lilyinstarlight/derailleurs/README.md

The Derailleurs
===============

The Derailleurs aim to create a system for automatic rear gear switching on a standard bicycle. This repository contains everything we've made toward that goal.
