lilyinstarlight/derailleurs/hardware/greenboard/900-CH-7222-TH-TOP.tsv

DNP | J4 | 20.28 | 67.54 | 270
DNP | J3 | 2.5 | 67.54 | 90
DNP | J7 | 11.39 | 5.55 | 270
DNP | J5 | 2.5 | 34.53 | 90
DNP | J6 | 20.28 | 34.53 | 270
