lilyinstarlight/derailleurs/hardware/models/sensor_mount_top.stl

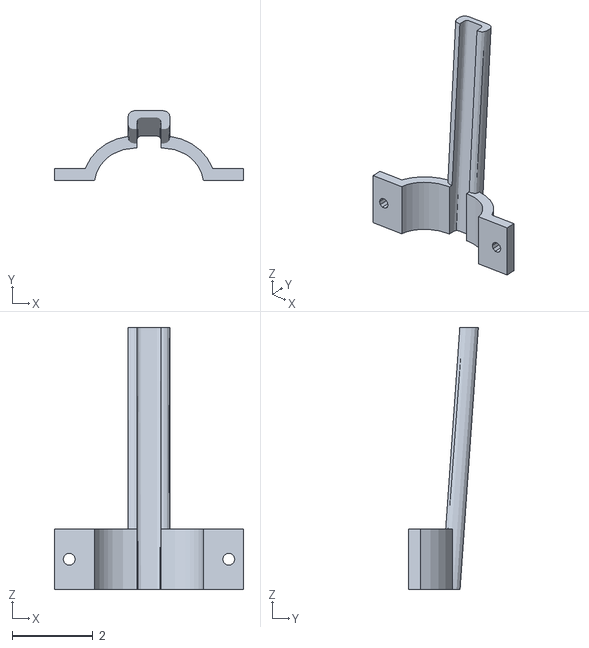
[picture p1: CAD file, 2016-11-09]
hardware/models/sensor_mount_top.stl
4.69 x 1.73 x 6.48
