lilyinstarlight/derailleurs/hardware/models/sensor_mount_bot.stl

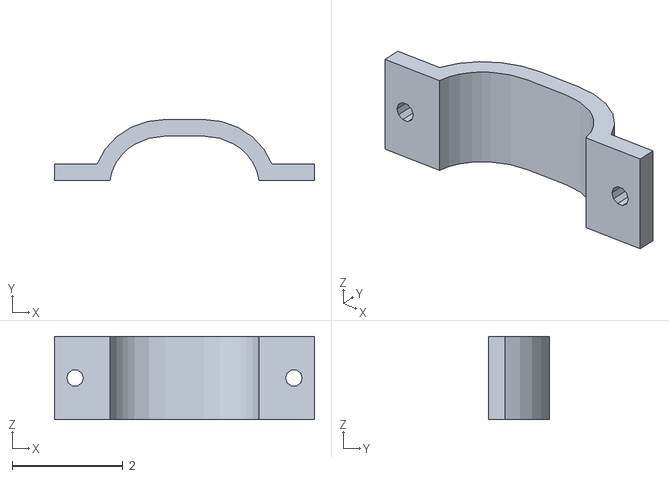
[picture p2: CAD file, 2016-11-09]
hardware/models/sensor_mount_bot.stl
4.69 x 1.10 x 1.50
