lilyinstarlight/derailleurs/hardware/models/turnbuckle_clamp_v1.stl

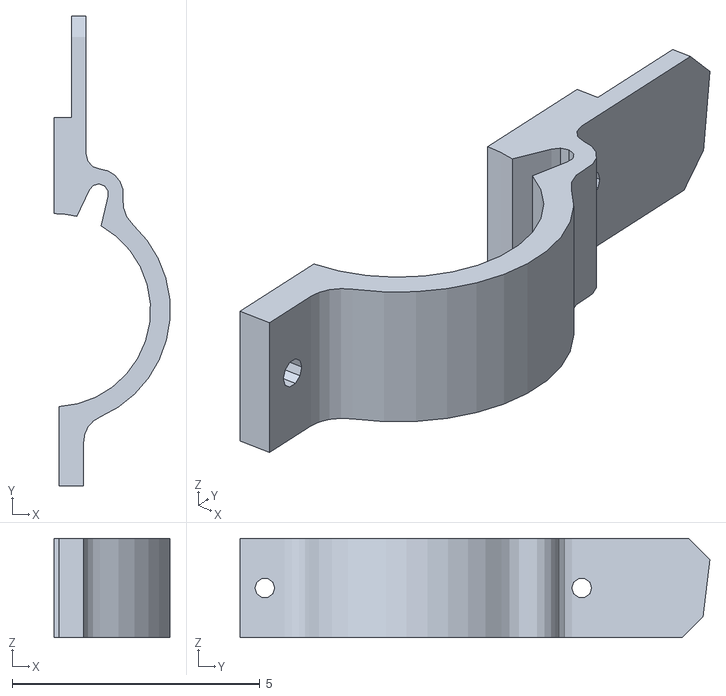
[picture p3: CAD file, 2016-11-07]
hardware/models/turnbuckle_clamp_v1.stl
2.34 x 9.49 x 2.00
