lilyinstarlight/derailleurs/hardware/models/motor_mount_v1_2.stl

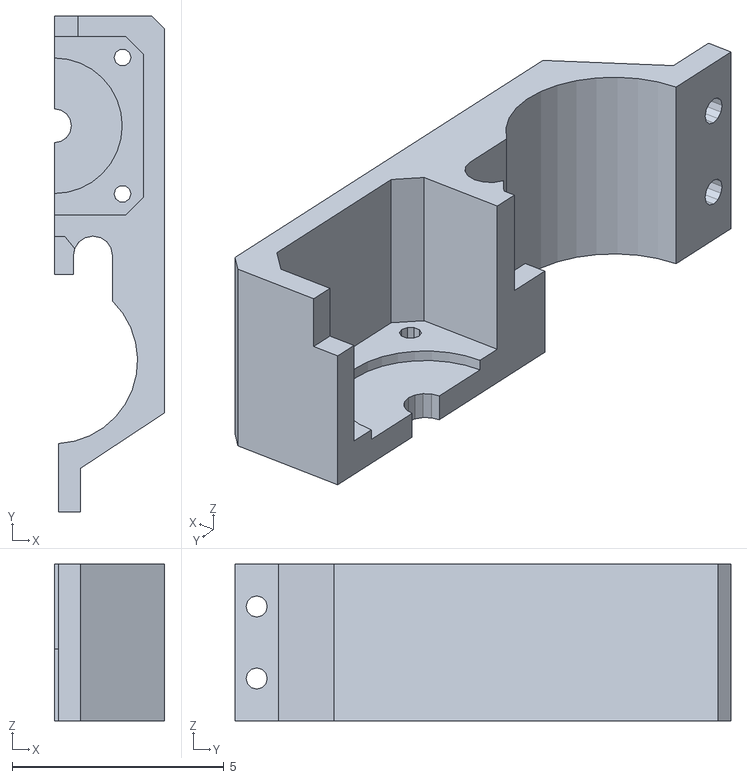
[picture p4: CAD file, 2016-11-04]
hardware/models/motor_mount_v1_2.stl
2.60 x 11.7 x 3.70
