lilyinstarlight/derailleurs/(list of files, cad)

Other CAD files:
hardware/models/motor_mount_v1.CATPart
hardware/models/turnbuckle_clamp_v1.CATPart
