lilyinstarlight/derailleurs/documents/testing.txt

=== TEAM INFO ===
Alice Stevens aksteve@clemson.edu
Foster McLane fmclane@clemson.edu
Mackenzie Binns mbinns@clemson.edu
Ryan Becwar rbecwar@g.clemson.edu

=== GITHUB INFO ===
github(current): https://github.com/fkmclane/derailleurs.git
buffet(mirror): buffet@buffet.cs.clemson.edu:mbinns/Derailleurs 

=== HALL EFFECT SENSOR TESTING ===
------------------------------------------------------------------------------
 hall_random_number:
------------------------------------------------------------------------------
    The hall random number test file tests a range of inputs that can be given from the hall effect sensor to ensure that it is calculating RPM correctly. The test is automatic and has a verify function that ensures the math is being done correctly based on the input given.

    We are calculating RPM based on the average number of magnets seen per second. This number is multiplied by 60 (to get a minute) then divided by 4 (number of magnets we have recording data) to get an RPM count for the rider

    This is important because it will control the motor telling it to shift either up or down

    To run this test open the diretory and run make upload, then to view the output run make monitor

------------------------------------------------------------------------------
 hall_decision_test:
------------------------------------------------------------------------------
    The decision test file is leveraging the random number generator from the last test to give the shift up and down commands. These commands are given if the cadence falls under a threshold (currently defined as 10 for proof of concept)

    This is important because without this logic the motor will never know when to shift the gear. This function will need to know the current gear of the bike and if the motor is currently shifting, so as not to send another shift command and allow the average to settle.

    To run this test open the diretory and run make upload, then to view the output run make monitor

------------------------------------------------------------------------------
* Hardware tests
------------------------------------------------------------------------------
    To ensure that the signal pin is really returning a HIGH signal, I wired up the hall effect and wired the signal and ground pins back to the bread board to control an LED. When the signal was HIGH The LED turned on when it was LOW it turned off. I then pedaled the bike to ensure it was turning off and on when expected and had no blips
    
    I then further verified this by having a multimeter hooked up to the signal pin to verify the input voltage (3.3v) was also being sent out of the signal pin (3.3v). If this hall sensor is wired wrong you will see a signifigant voltage drop and the board will not read the signal as high.

=== MOTOR LOGIC TESTING ===
------------------------------------------------------------------------------
motor_unit_test_1:
------------------------------------------------------------------------------
This unit test ensures that the motor module properly receives and processes a signal. The signal is simulated by the buttons on the microcontroller. The response should be the motor turning the proper amount.

The serial monitor indicates when a button has been pressed and how much the motor moves in response. There will be a short delay that indicates the signal to move is being sent to the motor.

This test is important because it ensures that the motor has the appropriate response to the gear changing signal it will receive. It also serves as a check for the motor settings. The delay time is appropriate for the set rotation speed and number of steps for shifting.

------------------------------------------------------------------------------
motor_unit_test_2:
------------------------------------------------------------------------------
This test ensures that the module can keep count of what gear it is on and not go over 7 or under 1. The enable pins should only active for a valid gear change. Simulate gear changes with the on board buttons.

The state of the enable pins, shifting, and gear are printed in the serial monitor.

This test is needed because it can be dangerous if the controller tries to shift outside of the gear range. It can completely derail the chain or cause the turnbuckle screw to come lose, dropping the cable. It also shows that the motor is only enabled when shifting, preventing unwanted power draw.

------------------------------------------------------------------------------
motor_unit_test_3:
------------------------------------------------------------------------------
This is an integrated test to automate the shifting. It is similar to unit test 2, but instead of being activated by manually pushing a button, it receives signals to shift from the sensor module.

The button inputs are replaced by two spare input pins that connect to the other microcontroller running hall_decision_test.

This test is important because it shows the integration of two modules that will be communicating on the final system.

=== INTERFACE TESTING ===
------------------------------------------------------------------------------
testWrite():
------------------------------------------------------------------------------
This test recreates the expected display text on the LCD in Serial out.
This is needed to verify that the text is formatted properly; if it is not, the display will be shifted off.

------------------------------------------------------------------------------
testCurrentAdjust():
------------------------------------------------------------------------------
This tests a function to adjust the current cadence.
The interface board will receive input form the decision board and adjust the current cadence to display accordingly.
This test is important to verify that the currentCadence can be properly set this way.

------------------------------------------------------------------------------
testSetGear():
------------------------------------------------------------------------------
This tests a function to update the current gear position display value.
The interface board will receive input from the decision board regarding what the current gear position is, and display it.
This test is important to verify that the gearPos variable can be correctly set given normal values.

------------------------------------------------------------------------------
testSetGearTooHigh():
------------------------------------------------------------------------------
This operates similarly to the above test, but supplies an invalid value as the gear.
The setGear(uint8_t) function should reduce any gear values greater than 8 to 8, or any less that 1 to 1 as these are impossible values.
This test verifies that, and is important to make sure that the display will show valid values in all situations.

The test case is built into the code through the use of a function called runTests() and the functions output will be printed to the serial monitor to emulate how it will be displayed on the LCD
