lilyinstarlight/derailleurs/hardware/interface/interface.brd

## EAGLE design hardware/interface/interface.brd (2016-10-04)

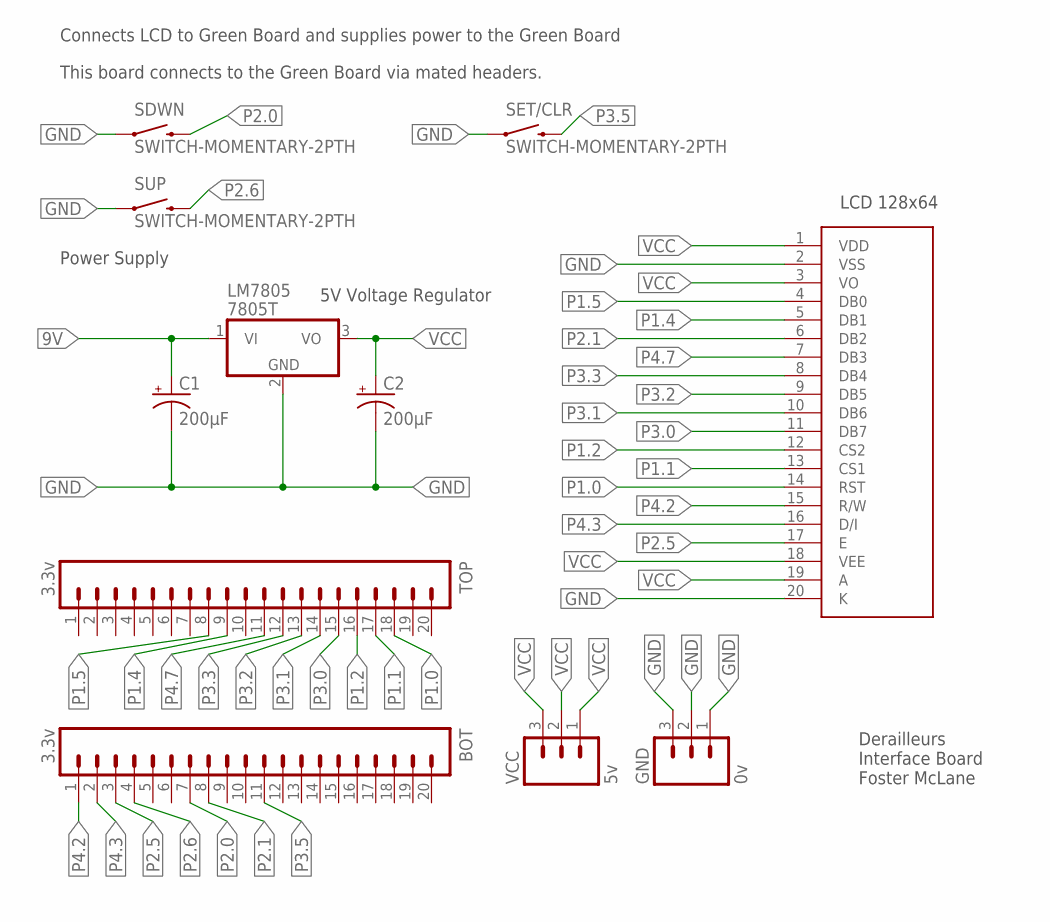
[picture p5: schematic interface.sch]

Parts:
BOT: 3.3v; 1X20
C1, C2: 200µF; CPOL-RADIAL-100UF-25V
GND: 0v; 1X03
LM7805: 7805T; TO220H
SDWN: SWITCH-MOMENTARY-2PTH; TACTILE-PTH
SET/CLR: SWITCH-MOMENTARY-2PTH; TACTILE-PTH
SUP: SWITCH-MOMENTARY-2PTH; TACTILE-PTH
TOP: 3.3v; 1X20
U$1: LCD-G12864FULL; LCD-G12864
VCC: 5v; 1X03

Connections:
9V: C1.1 (+), LM7805.1 (VI)
GND: C1.2 (-), C2.2 (-), GND.1, GND.2, GND.3, LM7805.2 (GND), SDWN.1, SET/CLR.1, SUP.1, U$1.2 (VSS), U$1.20 (K)
P1.0: TOP.18, U$1.14 (RST)
P1.1: TOP.17, U$1.13 (CS1)
P1.2: TOP.16, U$1.12 (CS2)
P1.4: TOP.9, U$1.5 (DB1)
P1.5: TOP.8, U$1.4 (DB0)
P2.0: BOT.7, SDWN.3 (2)
P2.1: BOT.8, U$1.6 (DB2)
P2.5: BOT.3, U$1.17 (E)
P2.6: BOT.4, SUP.3 (2)
P3.0: TOP.15, U$1.11 (DB7)
P3.1: TOP.14, U$1.10 (DB6)
P3.2: TOP.13, U$1.9 (DB5)
P3.3: TOP.12, U$1.8 (DB4)
P3.5: BOT.11, SET/CLR.3 (2)
P4.2: BOT.1, U$1.15 (R/W)
P4.3: BOT.2, U$1.16 (D/I)
P4.7: TOP.11, U$1.7 (DB3)
VCC: C2.1 (+), LM7805.3 (VO), U$1.1 (VDD), U$1.3 (VO), U$1.18 (VEE), U$1.19 (A), VCC.1, VCC.2, VCC.3

Notes on the sheet:
LCD 128x64
5V Voltage Regulator
Power Supply
Connects LCD to Green Board and supplies power to the Green Board
This board connects to the Green Board via mated headers.
Derailleurs Interface Board Foster McLane

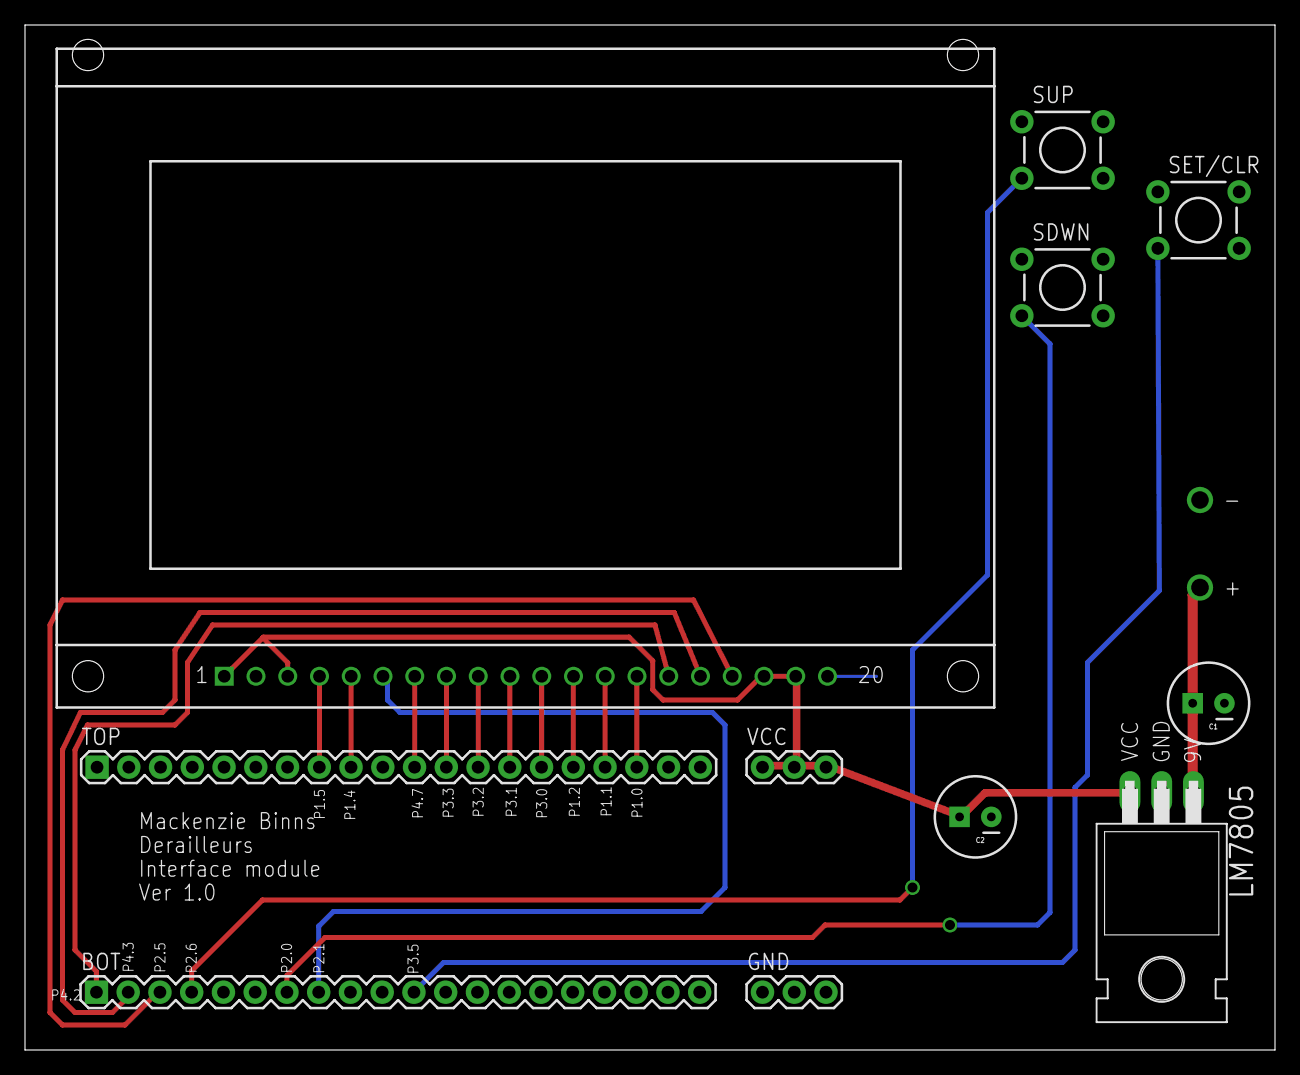
[picture p6: board interface.brd from above]

Board: 2 copper layers, 100.0 x 82.0 mm, 11 parts (0 on the bottom side), 20 nets.
