lilyinstarlight/derailleurs/hardware/switcher/switcher.brd

## EAGLE design hardware/switcher/switcher.brd (2016-10-04)

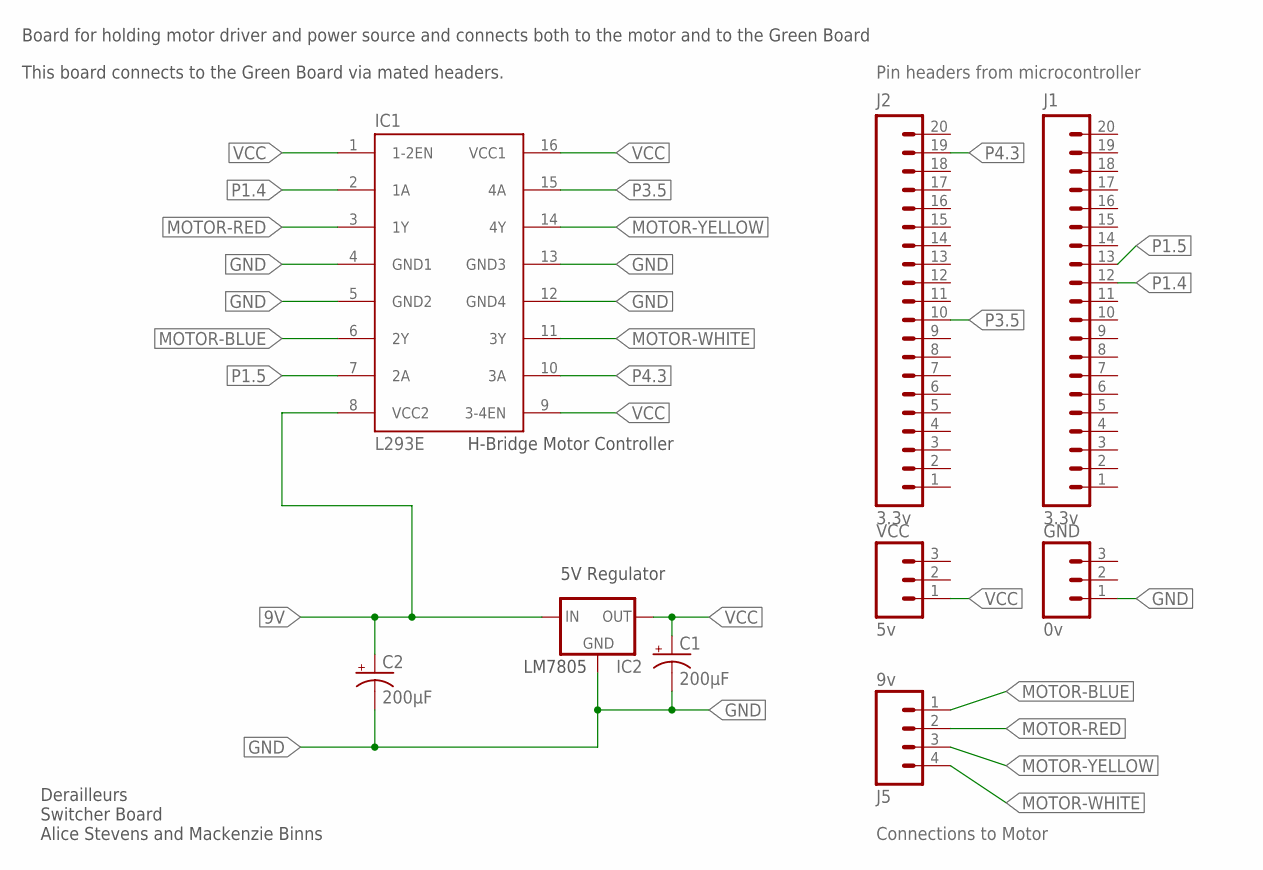
[picture p7: schematic switcher.sch]

Parts:
C1, C2: 200µF; CPOL-RADIAL-100UF-25V
GND: 0v; 1X03
IC1: L293E; DIL16
IC2: 78XXL
J1, J2: 3.3v; 1X20
J5: 9v; 1X04
VCC: 5v; 1X03

Connections:
9V: C2.1 (+), IC1.8 (VCC2), IC2.IN
GND: C1.2 (-), C2.2 (-), GND.1, IC1.4 (GND1), IC1.5 (GND2), IC1.12 (GND4), IC1.13 (GND3), IC2.GND
MOTOR-BLUE: IC1.6 (2Y), J5.1
MOTOR-RED: IC1.3 (1Y), J5.2
MOTOR-WHITE: IC1.11 (3Y), J5.4
MOTOR-YELLOW: IC1.14 (4Y), J5.3
P1.4: IC1.2 (1A), J1.12
P1.5: IC1.7 (2A), J1.13
P3.5: IC1.15 (4A), J2.10
P4.3: IC1.10 (3A), J2.19
VCC: C1.1 (+), IC1.1 (1-2EN), IC1.9 (3-4EN), IC1.16 (VCC1), IC2.OUT, VCC.1

Notes on the sheet:
Board for holding motor driver and power source and connects both to the motor and to the Green Board
H-Bridge Motor Controller
LM7805
5V Regulator
This board connects to the Green Board via mated headers.
Derailleurs Switcher Board Alice Stevens and Mackenzie Binns
Pin headers from microcontroller
Connections to Motor

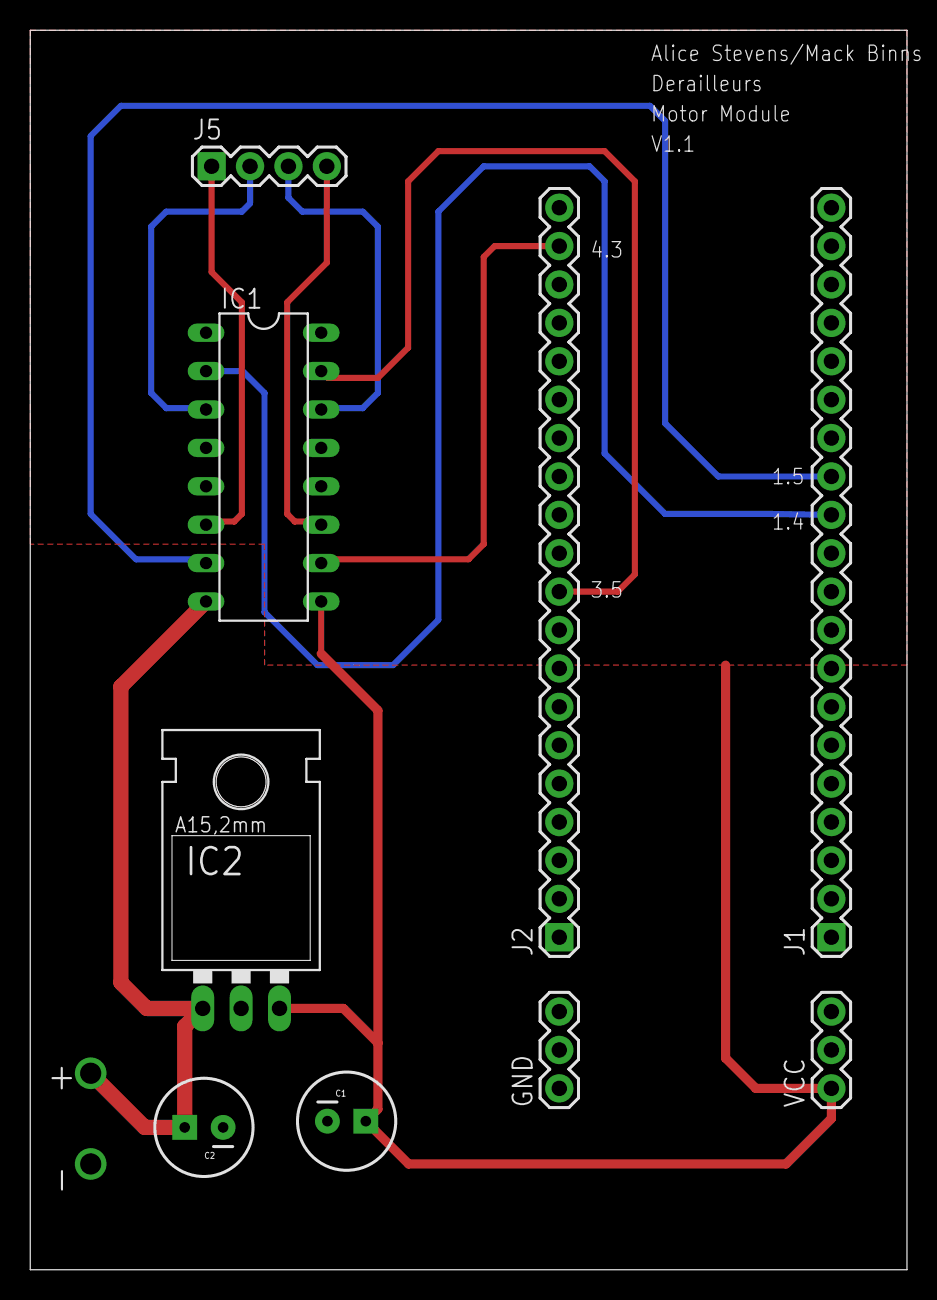
[picture p8: board switcher.brd from above]

Board: 2 copper layers, 58.0 x 82.0 mm, 9 parts (0 on the bottom side), 11 nets.
