lilyinstarlight/derailleurs/hardware/decision/decision.brd

## EAGLE design hardware/decision/decision.brd (2016-10-04)

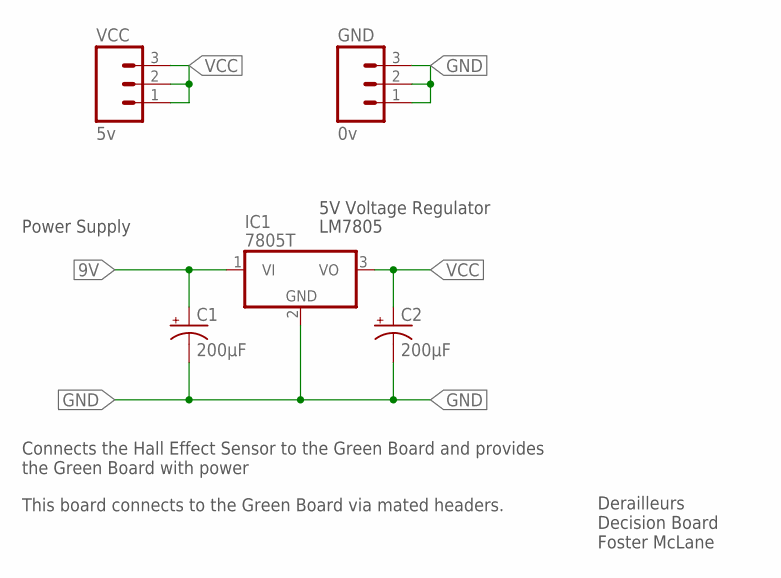
[picture p9: schematic decision.sch]

Parts:
C1, C2: 200µF; CPOL-RADIAL-100UF-25V
GND: 0v; 1X03
IC1: 7805T; TO220H
VCC: 5v; 1X03

Connections:
9V: C1.1 (+), IC1.1 (VI)
GND: C1.2 (-), C2.2 (-), GND.1, GND.2, GND.3, IC1.2 (GND)
VCC: C2.1 (+), IC1.3 (VO), VCC.1, VCC.2, VCC.3

Notes on the sheet:
LM7805
5V Voltage Regulator
Connects the Hall Effect Sensor to the Green Board and provides the Green Board with power
This board connects to the Green Board via mated headers.
Derailleurs Decision Board Foster McLane
Power Supply

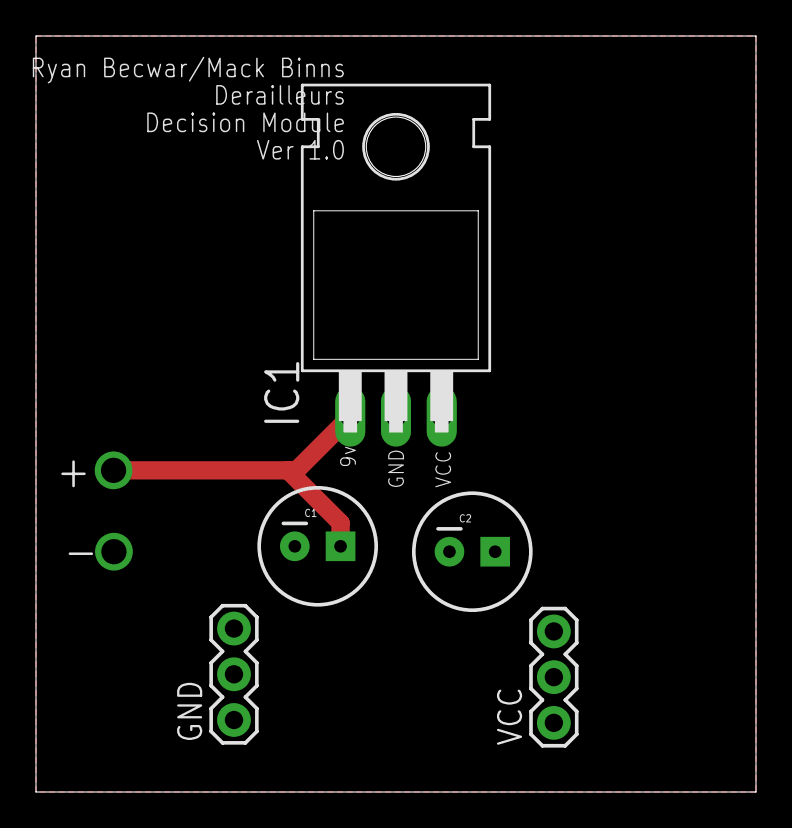
[picture p10: board decision.brd from above]

Board: 2 copper layers, 40.0 x 42.0 mm, 5 parts (0 on the bottom side), 3 nets.
