lilyinstarlight/derailleurs/hardware/greenboard/eda/Breadboard.brd

## EAGLE design hardware/greenboard/eda/Breadboard.brd (2016-10-04)

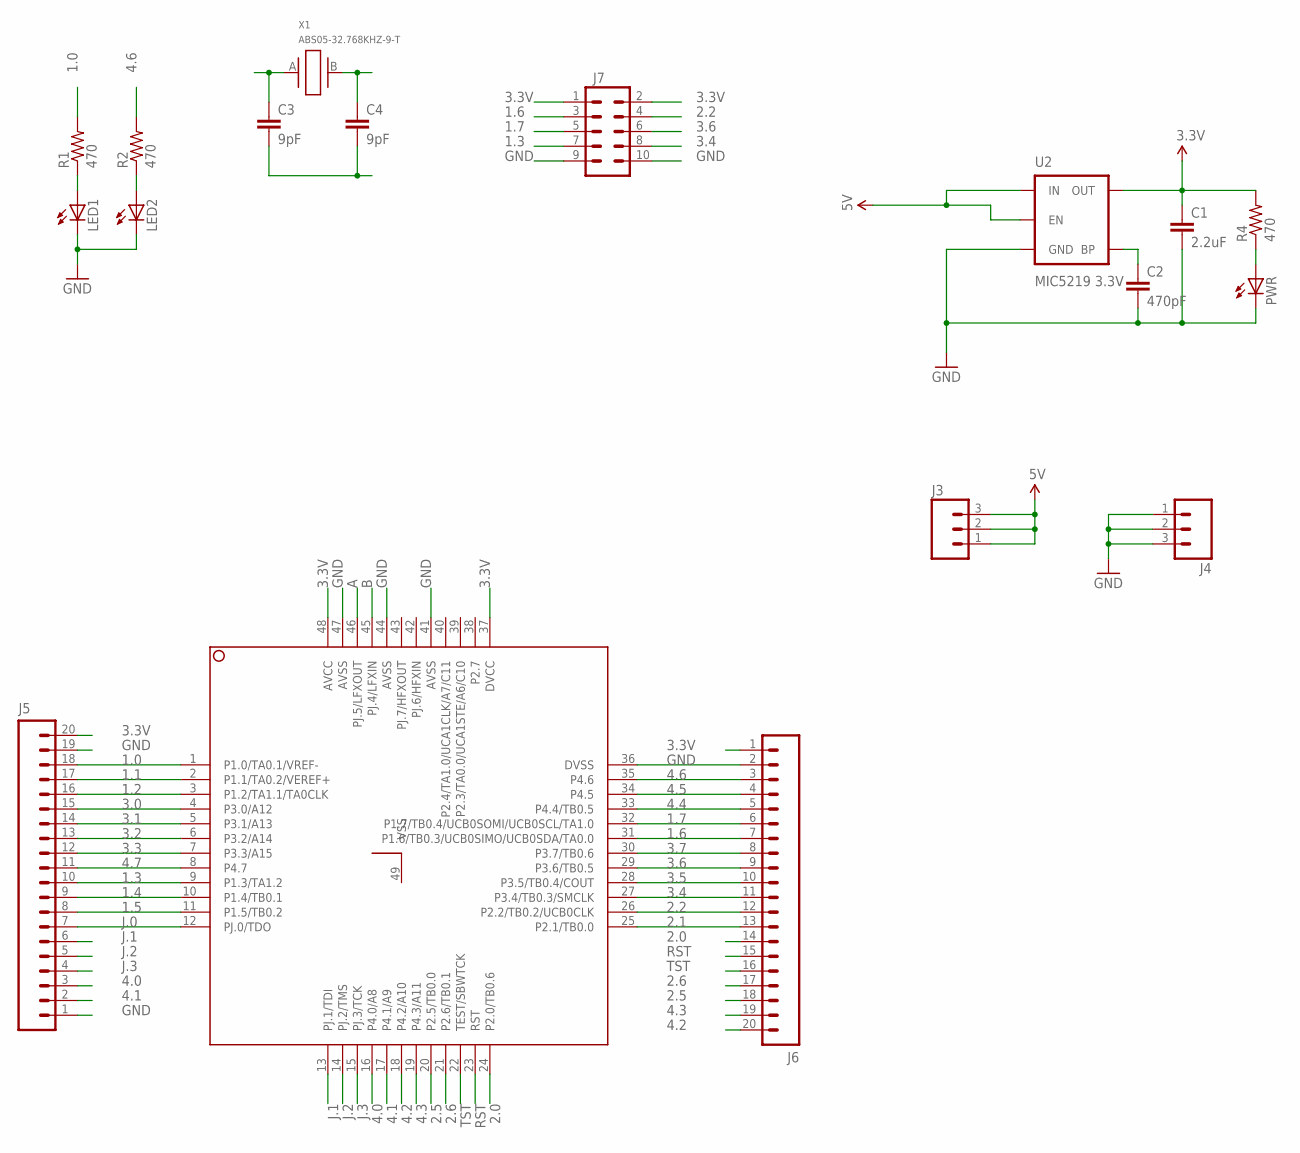
[picture p11: schematic Breadboard.sch]

Parts:
C1: 2.2uF; 0603-CAP
C2: 470pF; 0603-CAP
C3, C4: 9pF; 0603-CAP
J3, J4: M031X03_NO_SILK; 1X03_NO_SILK
J5, J6: M20NOSILK; 1X20_NOSILK
J7: M05X2NO_SILK; 2X5_NOSILK
LED1, LED2: LEDCHIPLED_0805; CHIPLED_0805
PWR: LEDCHIPLED_0805; CHIPLED_0805
R1, R2, R4: 470; 0805
U1: MSP430FR5969_RGZ_48; RGZ48_4P1X4P1
U2: MIC5219 3.3V; SOT23-5
X1: ABS05-32.768KHZ-9-T; ABS05

Connections:
1.0: J5.18, R1.2, U1.1 (P1.0/TA0.1/VREF-)
1.1: J5.17, U1.2 (P1.1/TA0.2/VEREF+)
1.2: J5.16, U1.3 (P1.2/TA1.1/TA0CLK)
1.3: J5.10, J7.7, U1.9 (P1.3/TA1.2)
1.4: J5.9, U1.10 (P1.4/TB0.1)
1.5: J5.8, U1.11 (P1.5/TB0.2)
1.6: J6.7, J7.3, U1.31 (P1.6/TB0.3/UCB0SIMO/UCB0SDA/TA0.0)
1.7: J6.6, J7.5, U1.32 (P1.7/TB0.4/UCB0SOMI/UCB0SCL/TA1.0)
2.0: J6.14, U1.24 (P2.0/TB0.6)
2.1: J6.13, U1.25 (P2.1/TB0.0)
2.2: J6.12, J7.4, U1.26 (P2.2/TB0.2/UCB0CLK)
2.5: J6.18, U1.20 (P2.5/TB0.0)
2.6: J6.17, U1.21 (P2.6/TB0.1)
3.0: J5.15, U1.4 (P3.0/A12)
3.1: J5.14, U1.5 (P3.1/A13)
3.2: J5.13, U1.6 (P3.2/A14)
3.3: J5.12, U1.7 (P3.3/A15)
3.3V: C1.1, J5.20, J6.1, J7.1, J7.2, R4.2, U1.37 (DVCC), U1.48 (AVCC), U2.5 (OUT)
3.4: J6.11, J7.8, U1.27 (P3.4/TB0.3/SMCLK)
3.5: J6.10, U1.28 (P3.5/TB0.4/COUT)
3.6: J6.9, J7.6, U1.29 (P3.6/TB0.5)
3.7: J6.8, U1.30 (P3.7/TB0.6)
4.0: J5.3, U1.16 (P4.0/A8)
4.1: J5.2, U1.17 (P4.1/A9)
4.2: J6.20, U1.18 (P4.2/A10)
4.3: J6.19, U1.19 (P4.3/A11)
4.4: J6.5, U1.33 (P4.4/TB0.5)
4.5: J6.4, U1.34 (P4.5)
4.6: J6.3, R2.2, U1.35 (P4.6)
4.7: J5.11, U1.8 (P4.7)
5V: J3.1, J3.2, J3.3, U2.1 (IN), U2.3 (EN)
A: C3.1, U1.46 (PJ.5/LFXOUT), X1.A (1)
B: C4.1, U1.45 (PJ.4/LFXIN), X1.B (2)
GND: C1.2, C2.2, C3.2, C4.2, J4.1, J4.2, J4.3, J5.1, J5.19, J6.2, J7.9, J7.10, LED1.C, LED2.C, PWR.C, U1.36 (DVSS), U1.41 (AVSS), U1.44 (AVSS), U1.47 (AVSS), U2.2 (GND)
J.0: J5.7, U1.12 (PJ.0/TDO)
J.1: J5.6, U1.13 (PJ.1/TDI)
J.2: J5.5, U1.14 (PJ.2/TMS)
J.3: J5.4, U1.15 (PJ.3/TCK)
unnamed: LED2.A, R2.1
unnamed: PWR.A, R4.1
unnamed: LED1.A, R1.1
unnamed: C2.1, U2.4 (BP)
RST: J6.15, U1.23 (RST)
TST: J6.16, U1.22 (TEST/SBWTCK)

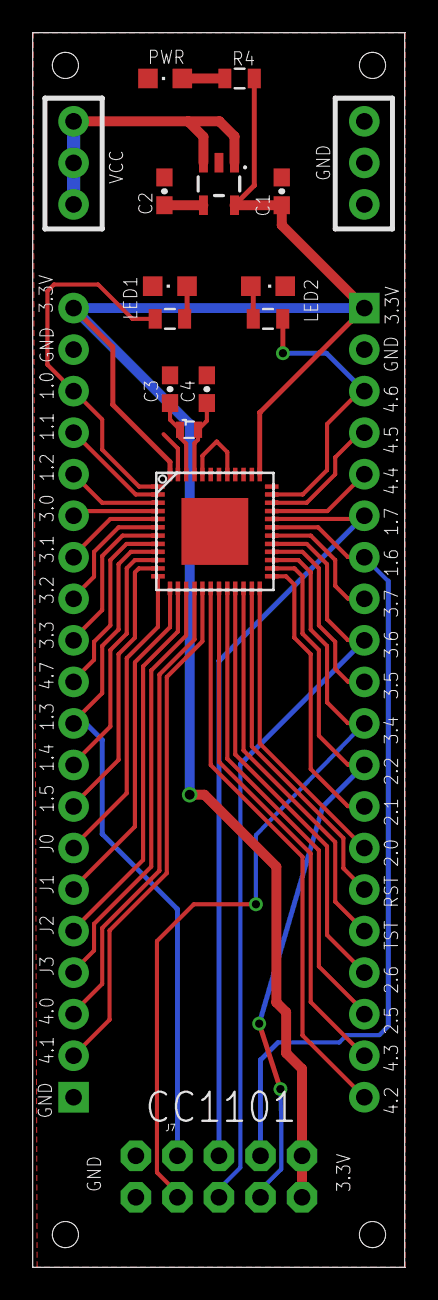
[picture p12: board Breadboard.brd from above]

Board: 2 copper layers, 22.8 x 75.5 mm, 18 parts (0 on the bottom side), 44 nets.
