lilyinstarlight/derailleurs/tinkering/hallsensor/testing/shiftingtests/hall_decision_test.ino

/*
 * Mackenzie Binns
 *
 * Hall Effect Sensor Module testing framework
 *
 * This code is used for a Latching hall effect sensor to calculate
 * The RPM of a bike being pedaled and to test the logic of decision
 * making, if the current cadence is 10 beyond target it will shift 
 * in an attempt to match the cadence back up you can see this code
 * does not shift +-10 of 75
 *
 * Version: 1.1
*/

#define NUMMAG 4
#define RPMSIZE 5
#define HALLPIN P1_5
#define SHIFT_PIN P4_3

unsigned long oldtime;
double average;

int rpm[RPMSIZE];
int rpmidx;
unsigned int revs;
int hallRead;
int switched;
int target;

void calc_average();
int speed_test(int magnets);

//Sends shifting commands
void shift_up();
void shift_down();
void check_cadence();

void setup()
{
    Serial.begin(9600);

    //Pull up to start
    pinMode(HALLPIN,INPUT_PULLUP);
    pinMode(P1_4,OUTPUT);
    pinMode(SHIFT_PIN,OUTPUT);
    pinMode(HALLPIN,INPUT_PULLDOWN);
    digitalWrite(P1_4,HIGH);

    //initialize variables
    switched = 0;
    revs = 0;
    oldtime = 0;
    average = 0;
    target = 75;

    //Seed the test for different numbers
    srand(millis());

    for (rpmidx = RPMSIZE - 1; rpmidx >= 0; rpmidx--)
        rpm[rpmidx] = 0;
}

void loop()
{
    hallRead = digitalRead(HALLPIN);

    // only reads once a second
    if(millis() - oldtime > 1000)
    {
        speed_test((rand() % 10)+1);
        calc_average();
        check_cadence();
    }
}

void calc_average()
{
    rpm[rpmidx] = revs;

    //Increase the index until you reace 5 then reset to zero
    rpmidx = (rpmidx + 1) % RPMSIZE;

    //Calculate the new moving average
    average = 0;
    for (int idx = 0; idx < RPMSIZE; idx++)
    {
        average += rpm[idx];
    }
    
    average /= RPMSIZE;
    
    //Sanity check for averages
    Serial.print("Average is: ");
    Serial.println(average);
    
    //Calculate RPM not RPS
    average *= 60;
    average /= NUMMAG;

    oldtime = millis();
    revs = 0;
     
    //TODO remove debug statement
    Serial.println(average,DEC);
}

//Set random number of magnets being detected per-second
int speed_test(int magnets)
{
    revs = abs(magnets);
    return 0;
}

void check_cadence()
{
    if((target - average) >= 10)
    {
        shift_down();
    }
    if((average - target) >= 10)
    {
        shift_up();
    }
}

void shift_up()
{
    Serial.println("SHIFT UP");
    digitalWrite(SHIFT_PIN,HIGH);
}

void shift_down()
{
    Serial.println("SHIFT DOWN");
}
