lilyinstarlight/derailleurs/(commit log)

2016-09-22 add MySerial library for our 2-wire serial implementation
2016-09-26 Fixing misspelling on directory
    [FibBlink.ino, RX.ino, SerialTest.ino, TX.ino]
2016-09-26 add schematic for the interface board
    [lcd.sch]
2016-09-26 Adding motor schematic
    [MotorChip.sch]
2016-09-26 Moving MotorChip.sch to hardware interfaces
    [MotorChip.sch]
2016-09-26 organize motorchip.sch into switch.sch
    [MotorChip.sch, interface.sch, switcher.sch]
2016-09-26 update schematics
    [decision.sch, switcher.sch]
2016-09-30 add capacitors
    [decision.sch, interface.sch, switcher.sch]
2016-10-03 add decision board file
    [decision.brd, decision.sch]
2016-10-03 update decision board with proper nets
    [decision.brd, decision.sch]
2016-10-03 working on decision board traces
    [decision.brd]
2016-10-03 Add interface.brd, it may need a copper pour
    [interface.brd]
2016-10-03 Add switcher.brd to repo, May need cleanup
    [switcher.brd]
2016-10-03 update decision board with copper pools, silk screen, and proper routes
    [decision.brd, decision.sch]
2016-10-03 update interface schematic
    [interface.brd, interface.sch]
2016-10-03 finish boards
    [decision.brd, interface.brd, interface.sch, switcher.brd, switcher.sch]
2016-10-04 Finish routing all boards, schematics are consitant, and all deliverable requirements are met..
    [900-CH-7222-TH-TOP.tsv, 900-CH-7222.tsv, Breadboard.brd, Breadboard.sch, PepeSilvia-Launchpad#7222.tsv, decision.brd, decision.sch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]
2016-10-04 Fix spelling mistake in derailleurs on silk screen
    [decision.brd, interface.brd, switcher.brd]
2016-11-01 testing sensor board
2016-11-01 Preliminary Hall Effect sensor code
2016-11-01 Test for motor using enable pins and buttons operation.
2016-11-01 Test for photoresistor on sensor board made in class.
2016-11-01 Test for accelerometer on sensorboard.
2016-11-02 adding model for motor mounting bracket
    [motor_mount_v1.CATPart, motor_mount_v1_2.stl]
2016-11-02 Update gitignore to not track DS_Store files
2016-11-02 Update hallsensor code to reflect changes in wiring on breadboard using pullup resistor
2016-11-03 Update motor mount model with slot for wires.
    [motor_mount_v1_2.stl]
2016-11-04 Got lcd driver working with MSP430
2016-11-04 Interface now displays target and current cadence, increments and decrements w buttons
2016-11-04 Toying with the RPM calculator, only returns 15 rpm increments, added a test folder for unit tests
2016-11-04 Finished random number average unit test for cal_average, updated rpm_module to have correct percision, working on shifting logic
    [hall_decision_test.ino, hall_random_number.ino, rpm_module.ino]
2016-11-04 Adding gear shifting code and unit test
2016-11-04 Fixing typos in motor unit tests
    [motor_unit_test_1.ino, motor_unit_test_2.ino]
2016-11-04 Added unit tests and current gear display
2016-11-04 Cleaning repo for deliverable 5, update testing.txt to spec, fixed warning messages in rpm_module and tests_modules
    [hall_random_number.ino, rpm_module.ino]
2016-11-04 Adding current motor module code and updating test code
2016-11-07 Added program to move motor and report change in step to tune gear change
2016-11-07 Updating motor programs with tuned gear change value
2016-11-07 Adding turnbuckle clamp model and stl
    [turnbuckle_clamp_v1.CATPart, turnbuckle_clamp_v1.stl]
2016-11-08 add decision and switcher files with working radio
2016-11-08 fix small compilation errors
    [decision.ino]
2016-11-08 fix small logic error
    [decision.ino]
2016-11-09 update switcher
2016-11-09 fix the gear numbering
    [decision.ino]
2016-11-09 Adding stls for sensor mount
    [sensor_mount_bot.stl, sensor_mount_top.stl]
2016-11-18 add comments and fix shifting
    [decision.ino, radio.ino, switcher.ino]
